FabienFerrero/UCA_AIOT/doc/Untitled.png

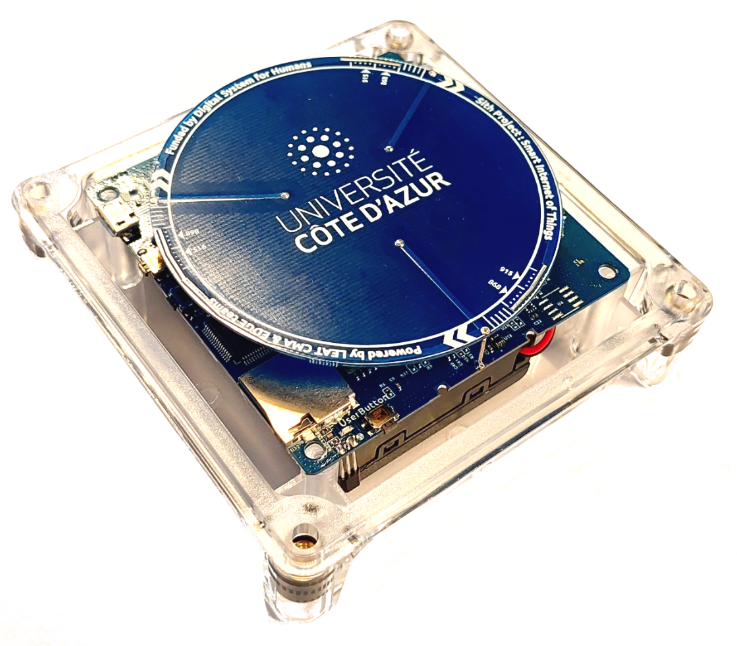
doc/Untitled.png
