FabienFerrero/UCA_AIOT/examples/7. Others/dkaiot_test_w_LacunaSpace-QuectelGPS/docs/packet_format_description.xlsx

Byte | Description | Value | Note
1 | Packet Type | 1 = Send to satellite 0 = Send to terrestrial gateways | N/A
2 | Packet Build Time | Bit [7:0] | Unit: UNIX Timestamp
3 |  | Bit [15:8]
4 |  | Bit [23:16]
5 |  | Bit [31:24]
6 | Battery ADC Value (12-bit resolution) | Bit [7:0] | Actual voltage = (ADC Value / 4095) * 4,5
7 |  | Bit [15:8]
8 | TLE Age Offset (to Packet Build Time) | Bit [7:0] | Unit: UNIX Timestamp
9 |  | Bit [15:8]
10 |  | Bit [23:16]
11 | Next Satellite Pass Offset (to Packet Build Time) | Bit [7:0] | Only available for Terrestrial Gateway transmission Unit: UNIX Timestamp
12 |  | Bit [15:8]
13 |  | Bit [23:16]
14 | Next GNSS Update Offset (to Packet Build Time) | Bit [7:0] | Unit: UNIX Timestamp
15 |  | Bit [15:8]
16 | Last GNSS Fix Duration | Bit [7:0] | Unit: Seconds
17 |  | Bit [15:8]
18 | GNSS Latitude | Bit [7:0] | Unit: 1e-7 Degree
19 |  | Bit [15:8]
20 |  | Bit [23:16]
21 |  | Bit [31:24]
22 | GNSS Longitude | Bit [7:0] | Unit: 1e-7 Degree
23 |  | Bit [15:8]
24 |  | Bit [23:16]
25 |  | Bit [31:24]
