FabienFerrero/UCA_AIOT/examples/7. Others/dkaiot_test_w_LacunaSpace-QuectelGPS/docs/packet_format_description.png

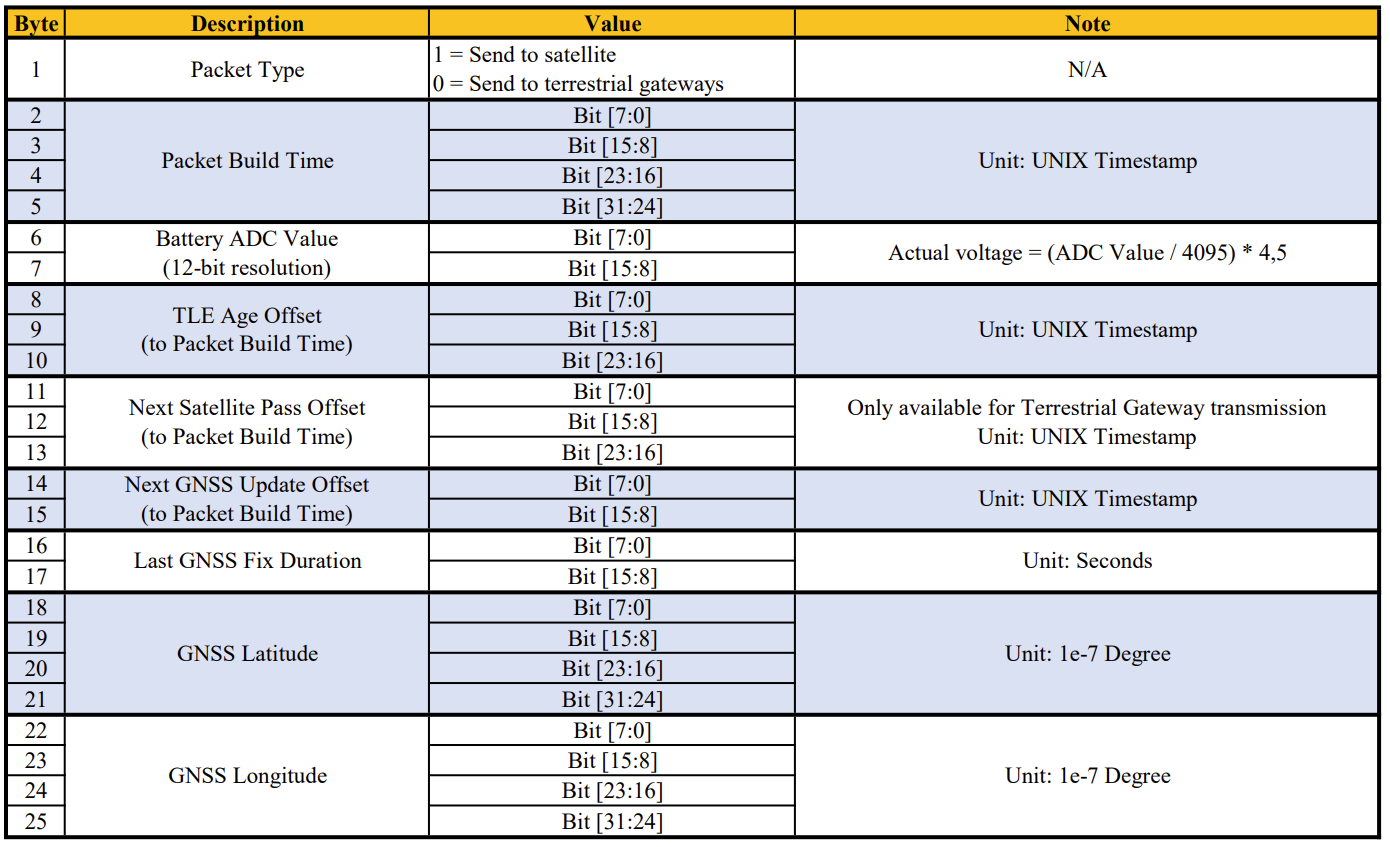
examples/7. Others/dkaiot_test_w_LacunaSpace-QuectelGPS/docs/packet_format_description.png
