FabienFerrero/UCA_AIOT/examples/7. Others/dkaiot_test_w_LacunaSpace-QuectelGPS/docs/ttn-sat-frequency.png

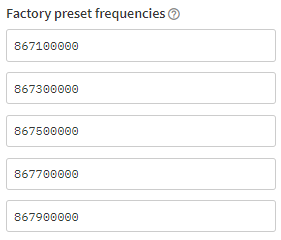
examples/7. Others/dkaiot_test_w_LacunaSpace-QuectelGPS/docs/ttn-sat-frequency.png
