FabienFerrero/UCA_AIOT/Schematic/AIoT-001-Jun2621-SCH.pdf

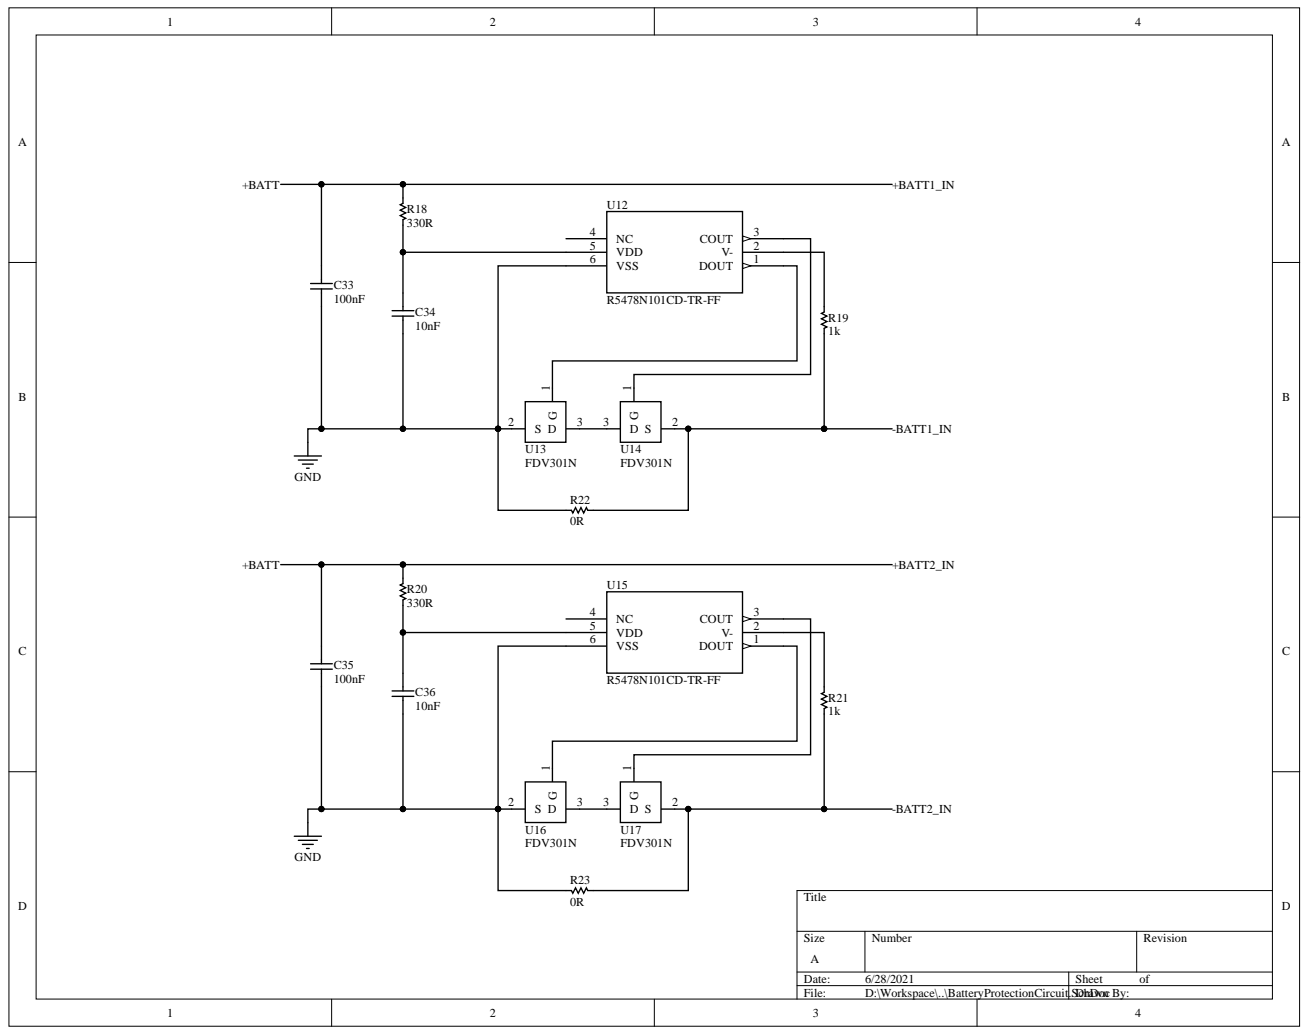
[picture p24: page 1]

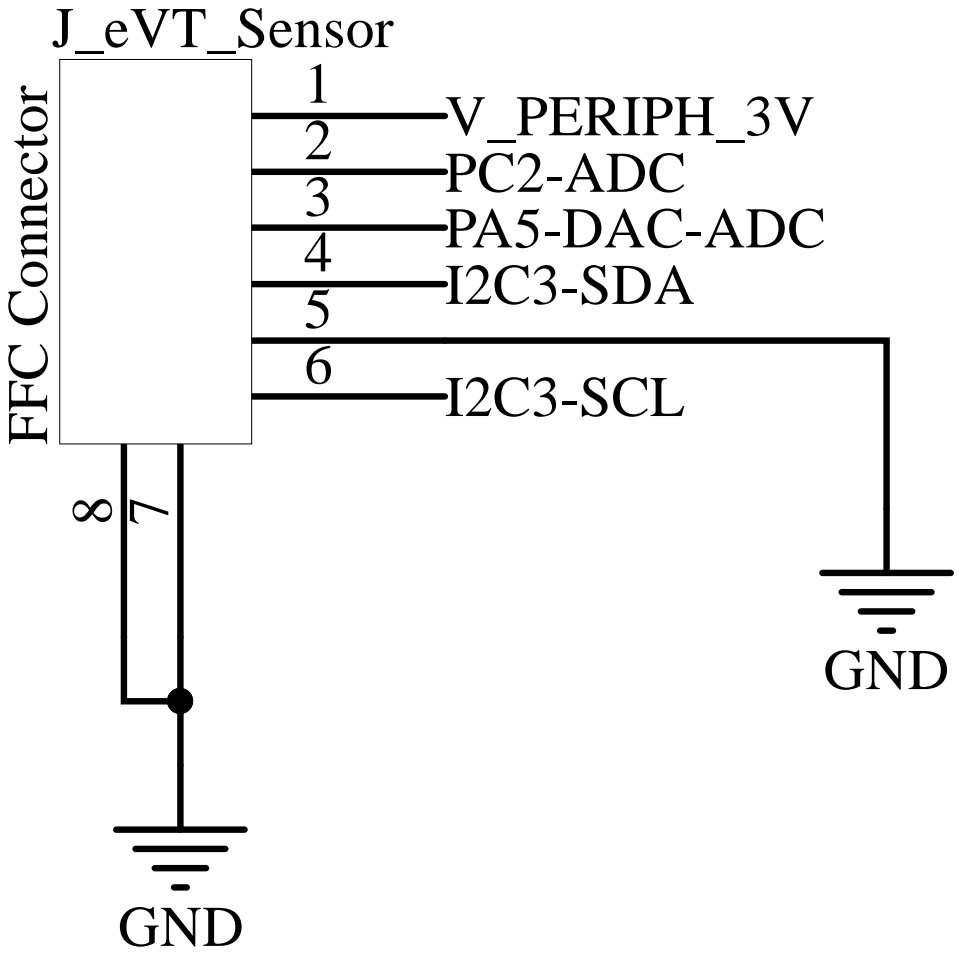
[picture p25: page 2]

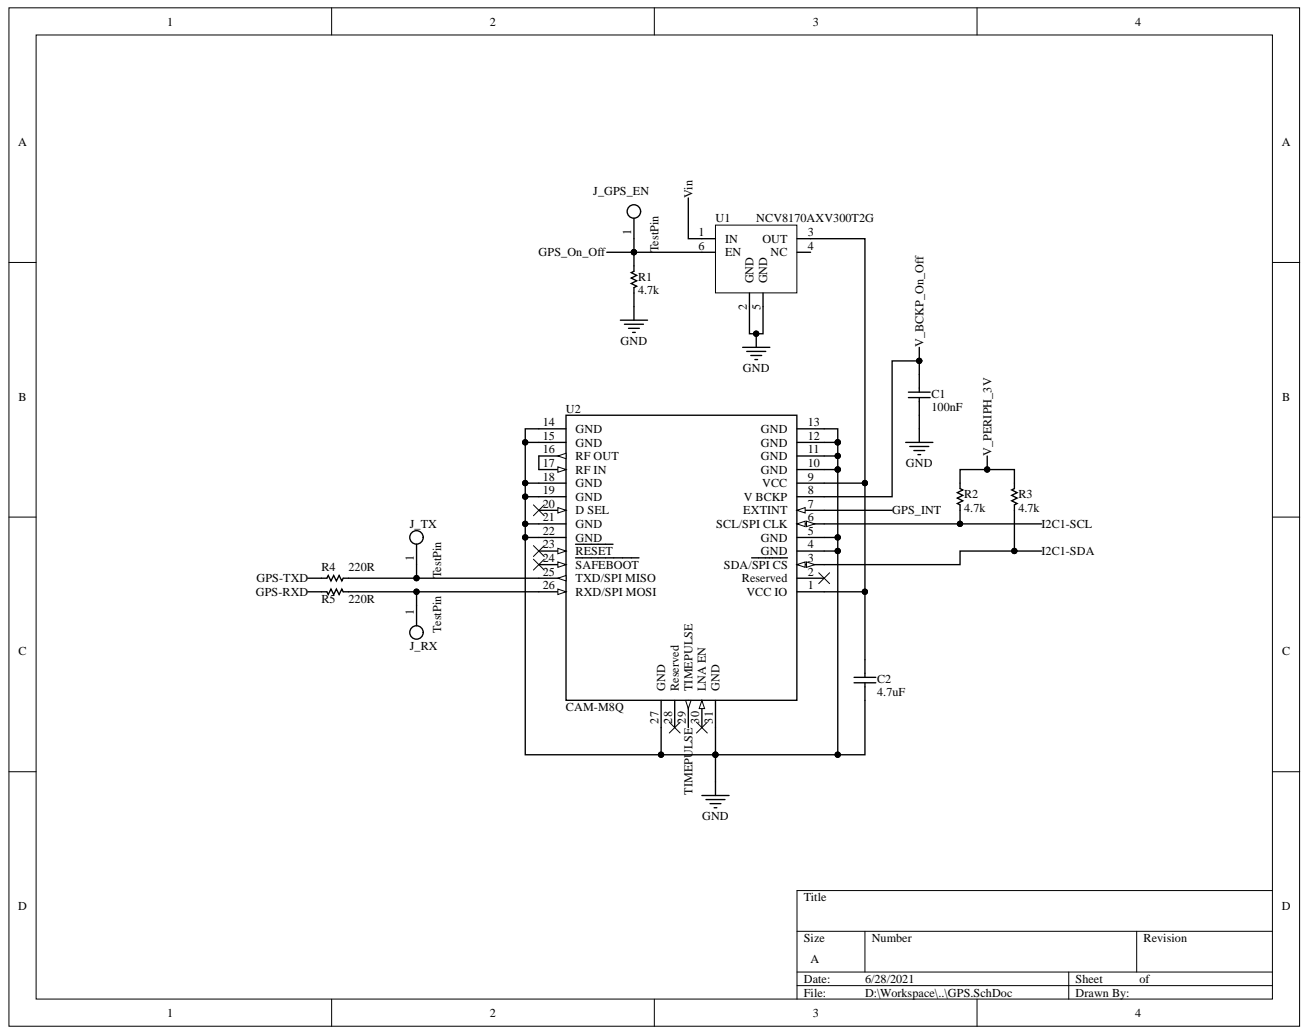
[picture p26: page 3]

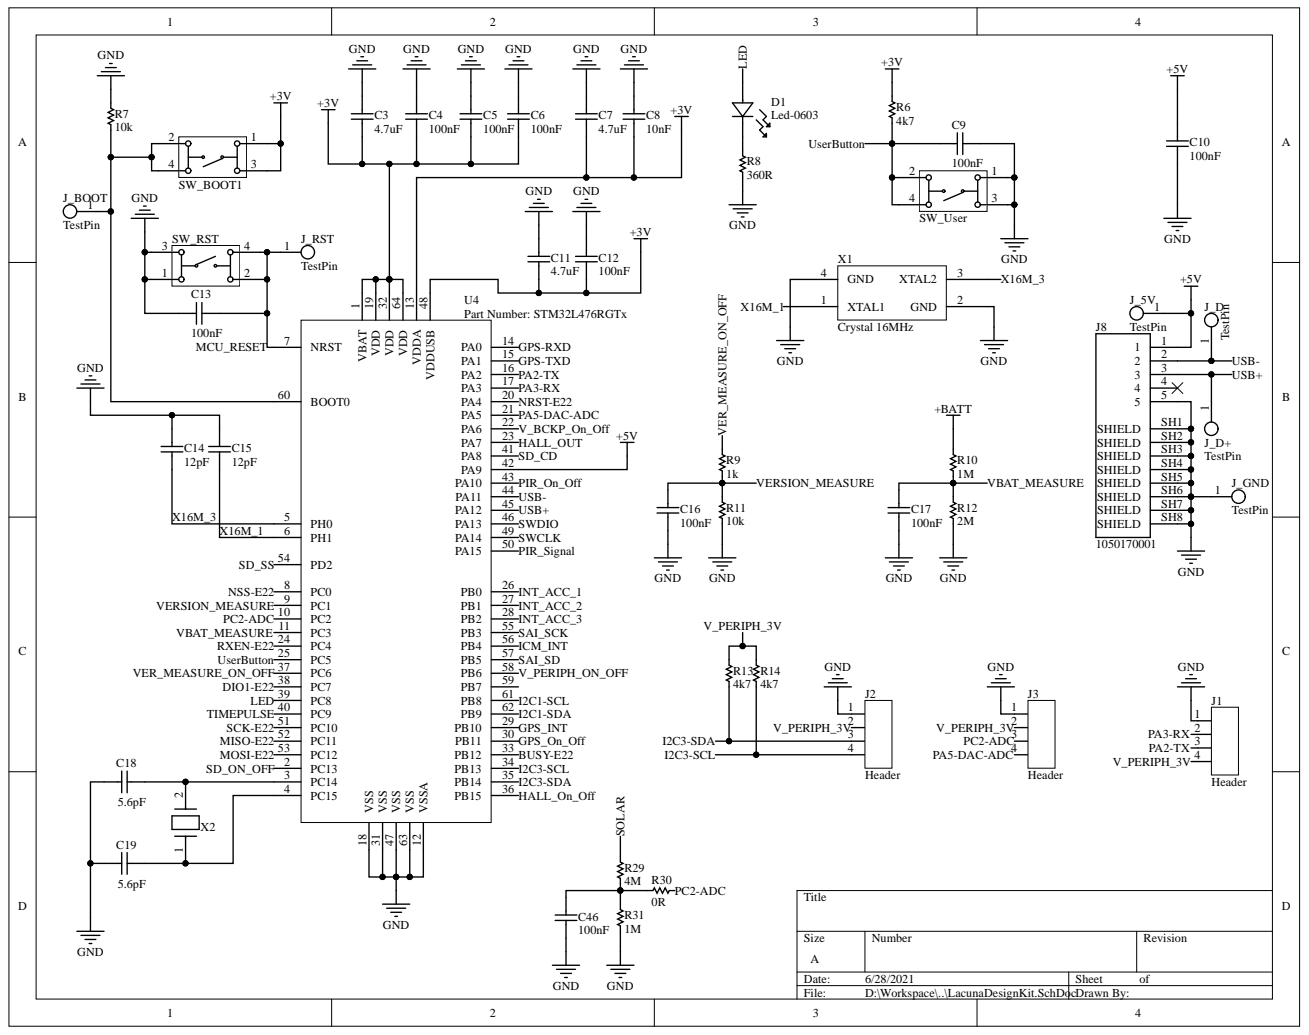
[picture p27: page 4]

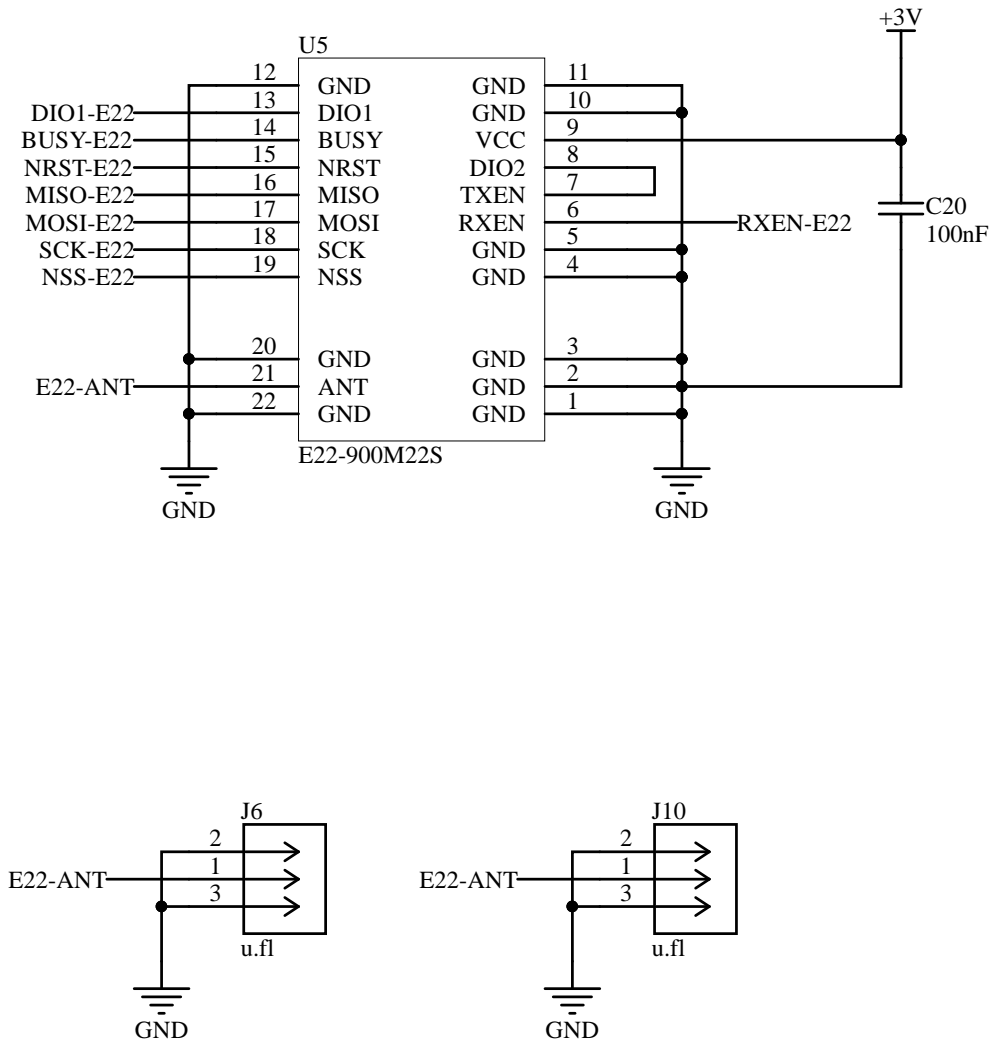
[picture p28: page 5]

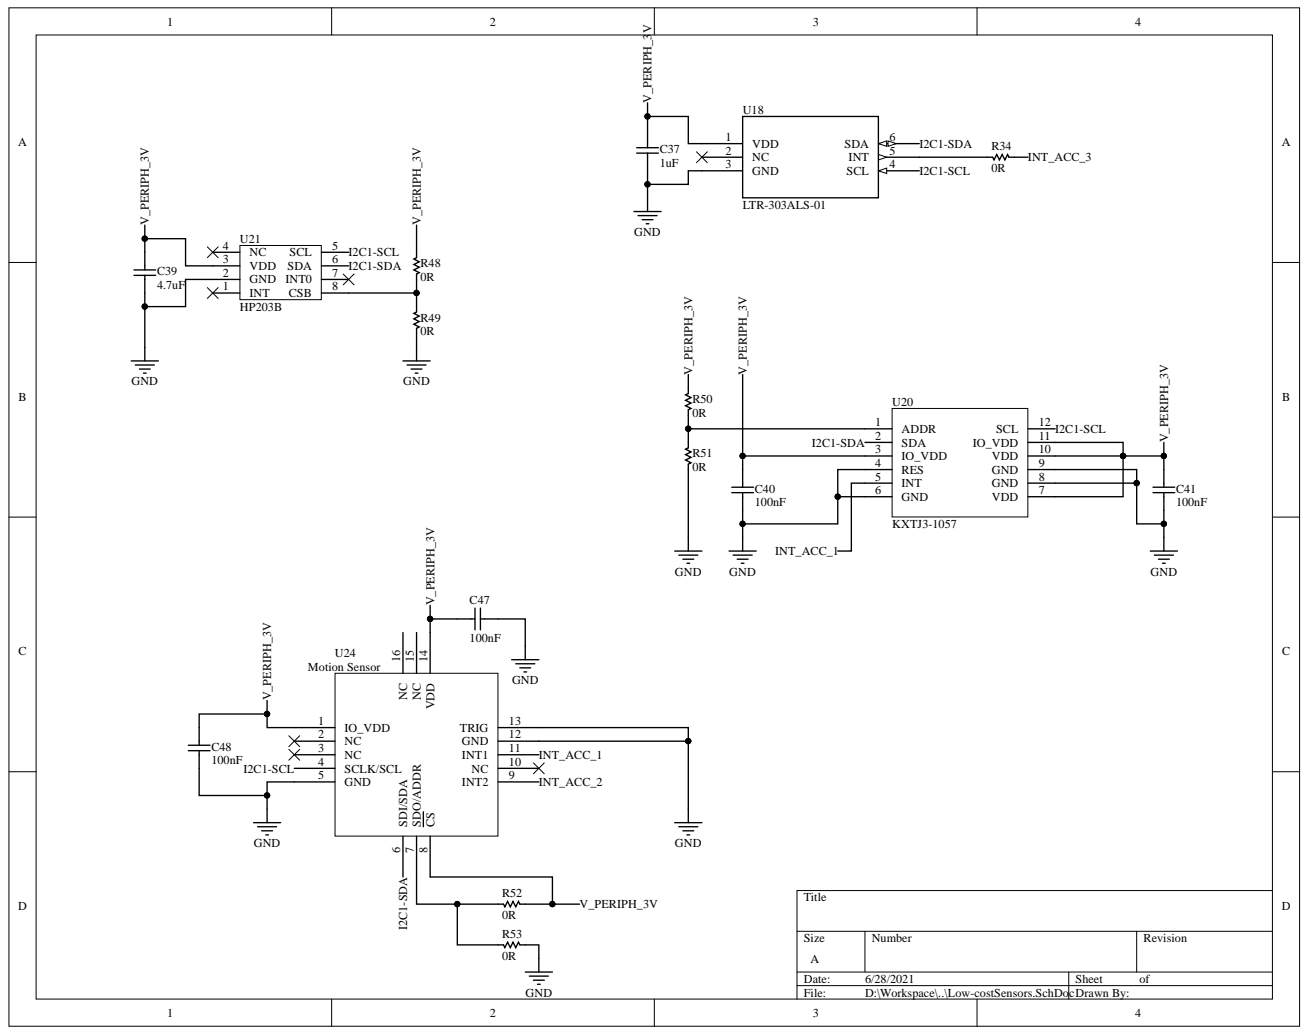
[picture p29: page 6]

IO_VDD 3

INT 5

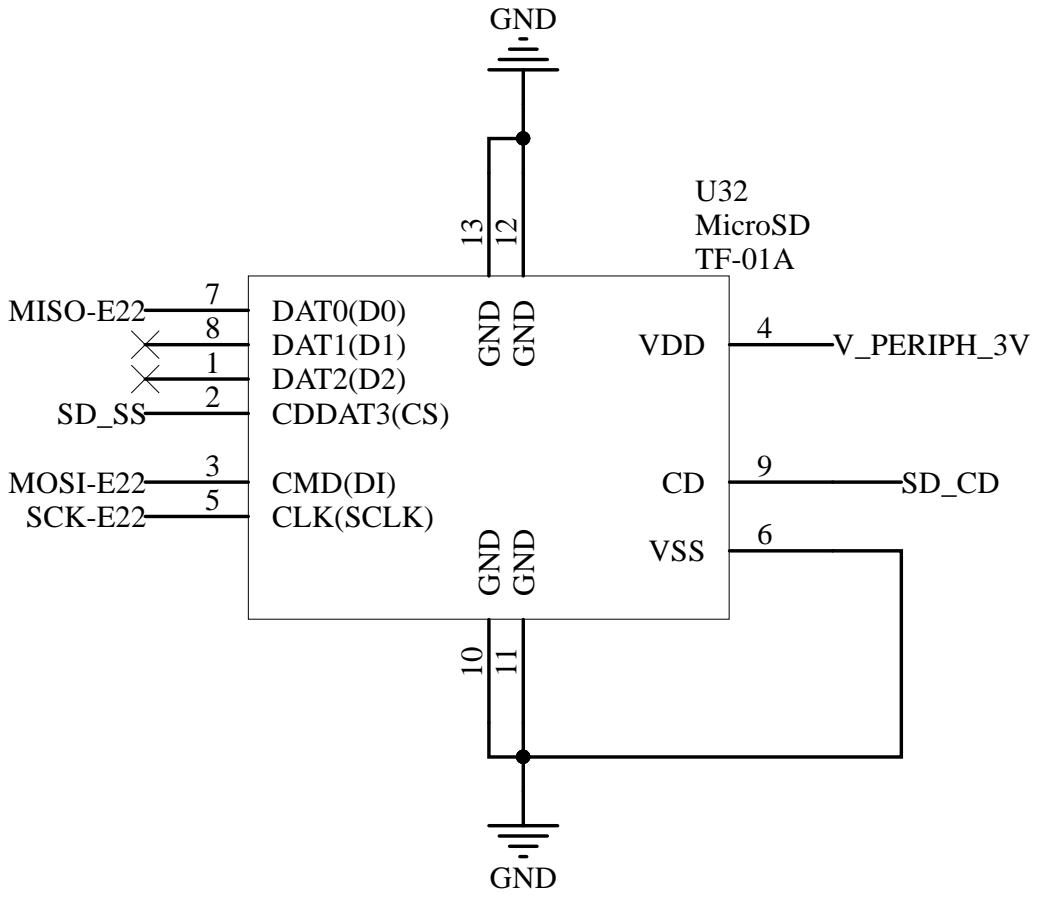
[picture p30: page 7]

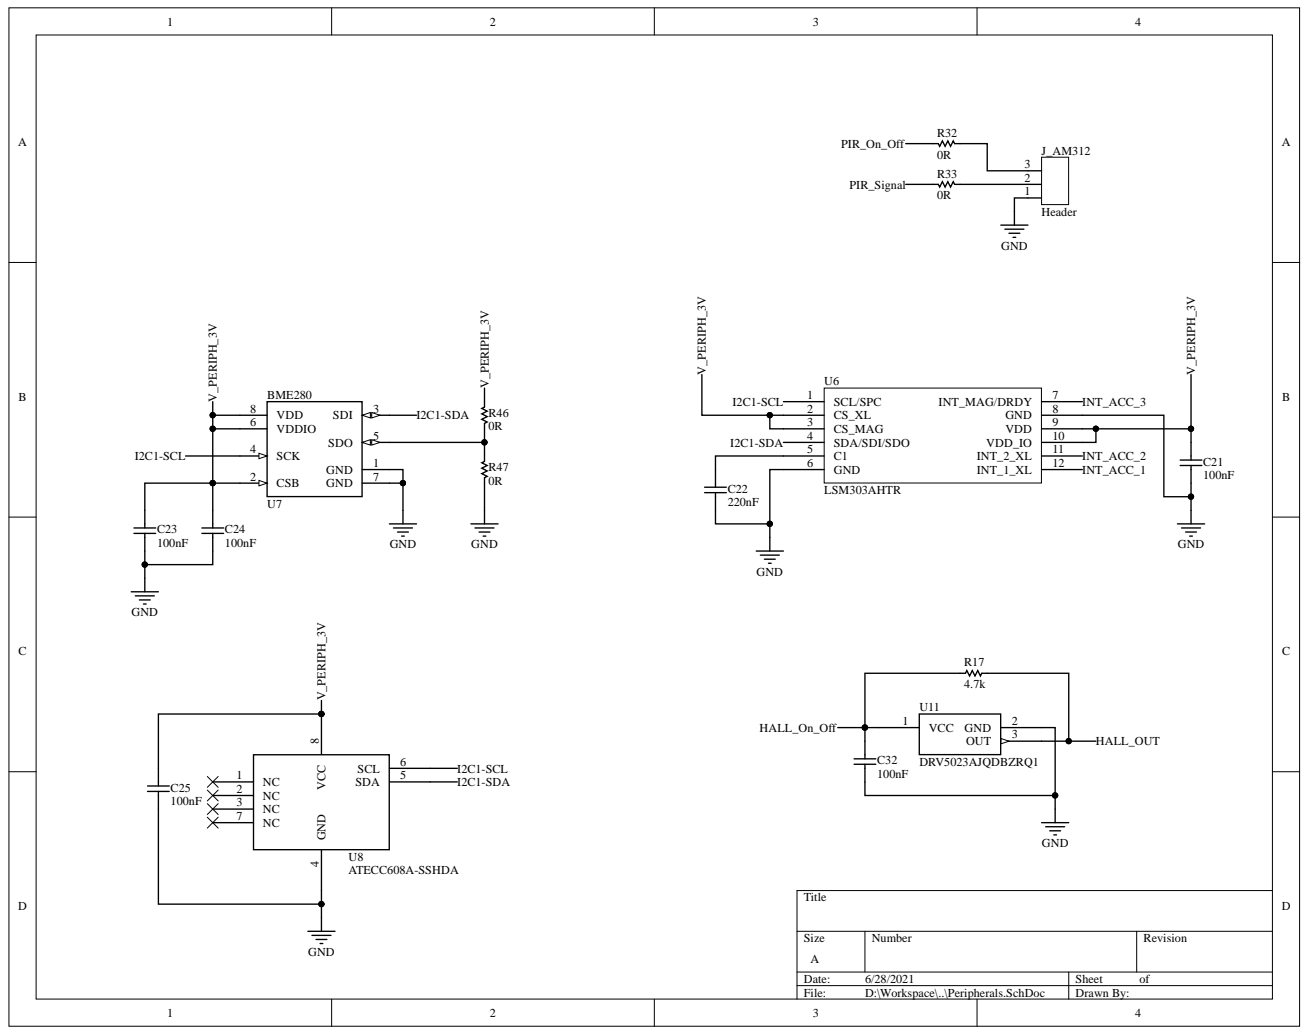
[picture p31: page 8]

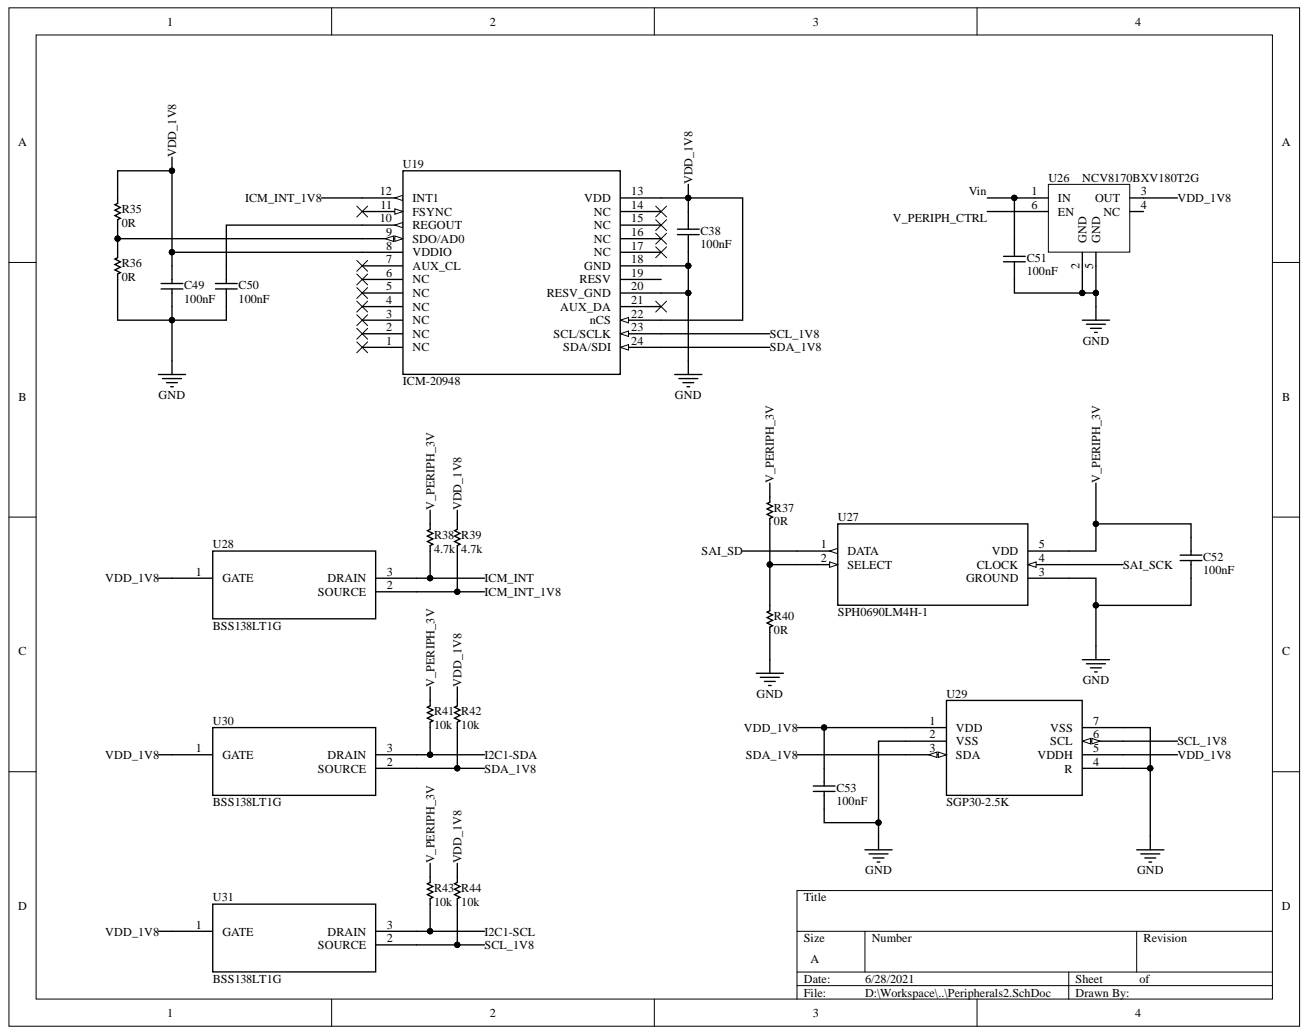
[picture p32: page 9]

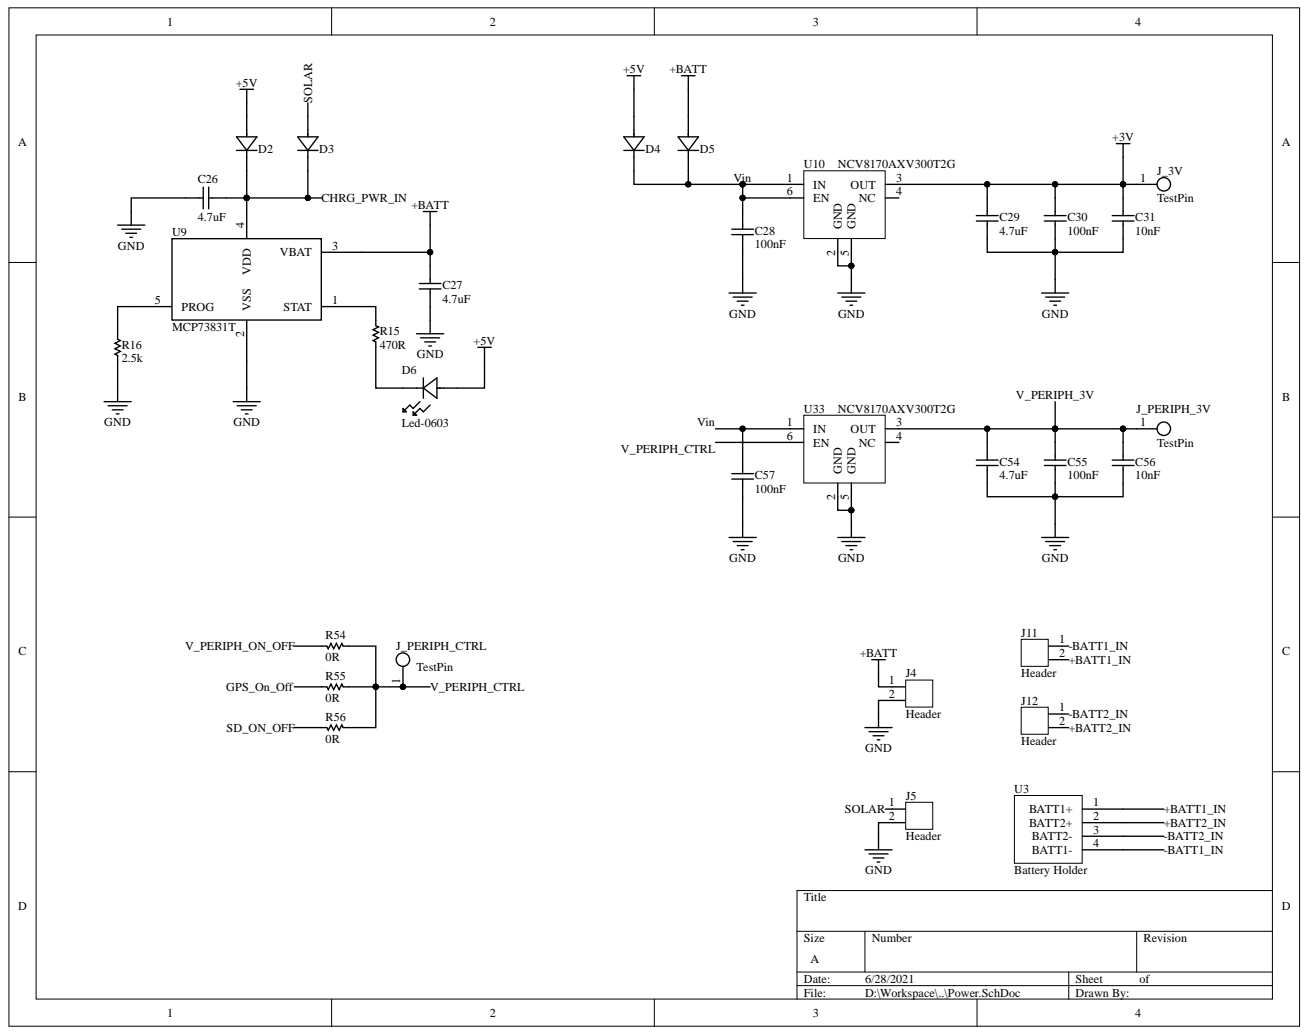
[picture p33: page 10]

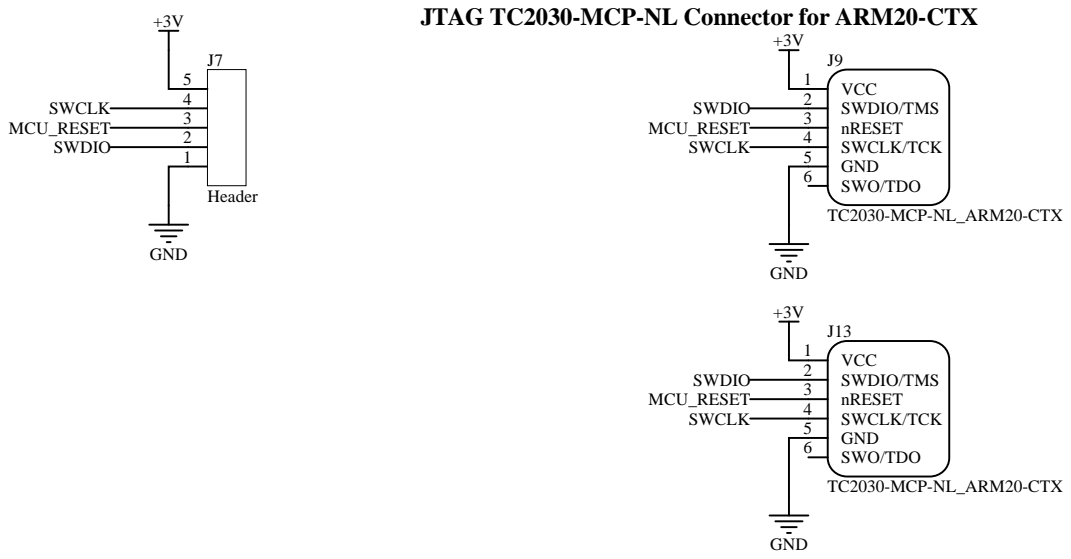
[picture p34: page 11]

JTAG TC2030-MCP-NL Connector for ARM20-CTX GND
