FabienFerrero/UCA_AIOT/examples/7. Others/SDCard_Test/SDCard_Test.ino

#include <SPI.h>
#include <SD.h>

#define SD_SS       10
#define SD_CD       38
#define SD_ON_OFF   44

File myFile;

void setup() {
  // GPIO
  pinMode(LS_LED_BLUE, OUTPUT);

  pinMode(LS_GPS_ENABLE, OUTPUT);
  digitalWrite(LS_GPS_ENABLE, HIGH);
  pinMode(LS_GPS_V_BCKP, OUTPUT);
  digitalWrite(LS_GPS_V_BCKP, HIGH);
  pinMode(SD_ON_OFF, OUTPUT);
  digitalWrite(SD_ON_OFF, HIGH);

  pinMode(LS_VERSION_ENABLE, OUTPUT);
  digitalWrite(LS_VERSION_ENABLE, LOW);


  // Serial
  Serial.begin(9600);
  while (!Serial && (millis() < 5000))
  {
  }

  Serial.print("Initializing SD card...");
  if (!SD.begin(10)) {
    Serial.println("initialization failed!");
    while (1);
  }

  Serial.println("initialization done.");
  // open the file. note that only one file can be open at a time,
  // so you have to close this one before opening another.
  myFile = SD.open("test.txt", FILE_WRITE);
  // if the file opened okay, write to it:
  if (myFile) {
    Serial.print("Writing to test.txt...");
    myFile.println("This is a test file :)");
    myFile.println("testing 1, 2, 3.");
    for (int i = 0; i < 20; i++) {
      myFile.println(i);
    }
    // close the file:
    myFile.close();
    Serial.println("done.");
  } else {
    // if the file didn't open, print an error:
    Serial.println("error opening test.txt");
  }
}
void loop() {
}
