FabienFerrero/UCA_AIOT/(commit log)

2022-11-21 Add: An example for hardware testing of on-board sensors
2022-11-21 Add: Libraries for sensors on UCA_AIoT board
2022-11-21 Update: Update the board index JSON file
2022-11-22 Add: Sensor examples for ICM-20948 & SGP30-2.5K
2022-11-22 Update: bug fixing on doppler test TX
    [lora_phy_doppler_simulate_tx_example.ino]
2022-11-22 Add: LoRaWAN sensor example
2022-11-27 Add: Document for external sensor/device connectivity
2023-03-16 Update: Test board JSON link
2023-03-17 Update: Patch the LacunaSpace example bug with sleep forever
    [dkaiot_test_w_LacunaSpace.ino]
2023-03-17 Update: README for Lacuna Space example - Add Packet format description
    [packet_format_description.xlsx]
2023-03-21 Update: Patch GNSS Update issue
    [dkaiot_test_w_LacunaSpace.ino]
2023-04-26 Add: dkaiot_test_w_LacunaSpace for Quectel L96 board version
    [packet_format_description.xlsx]
2023-04-26 Update: Fix Serial.println missing in LacunaSpace example for Quectel GNSS module
    [dkaiot_test_w_LacunaSpace-QuectelGPS.ino]
2023-07-25 Update dkaiot_test_w_LacunaSpace_otaa.ino: Correct variable naming pattern
    [dkaiot_test_w_LacunaSpace_otaa.ino]
2023-09-15 Update: Correct GNSS reading procedure in gnss_quectel_example.ino
    Update:
    [gnss_quectel_example.ino]
2023-09-15 Add I2C_Scanner example
2023-11-10 Update payload_formatter.js
    Correct accelerometer value
